einsteinx2/fan_hdd_caddy/(commit log)

2026-06-09 First pass, still needs more refinement
    [fan_hdd_caddy.scad]
2026-06-09 Added ventilation and more structure
    [fan_hdd_caddy.scad]
2026-06-09 First pass at making screws optional
    [fan_hdd_caddy.scad]
2026-06-09 Improve hard drive alignment bumps
    [fan_hdd_caddy.scad]
2026-06-13 Split base and collar to allow printing flat on bed without supports
    [fan_hdd_caddy.scad]
2026-06-13 Add locking tabs to secure the collar
    [fan_hdd_caddy.scad]
2026-06-13 Fixed bumps overlapping base screw holes
    [fan_hdd_caddy.scad]
2026-06-13 Split top stips into separate pieces to remove final need for supports
    [fan_hdd_caddy.scad]
2026-06-13 Add some vertical play for the drives
    [fan_hdd_caddy.scad]
2026-06-13 Remove need for supports when printing the collar
    [fan_hdd_caddy.scad]
2026-06-13 Add export script for 3mf and stl files
2026-06-13 Export the bands upside down to lay flat on bed
    [fan_hdd_caddy.scad]
2026-06-14 Optimize print time and filament usage in main body and square off corners to support any corner radius
    [fan_hdd_caddy.scad]
2026-09-05 Rework the caddy as one rigid piece for a case-top mount
    The caddy now sits on a PC case top, over a 140mm fan under it. The
    corner screws pass through the case into the fan, so the collar that
    wrapped the fan, its rest tabs, and its lock detents have no purpose.
    Remove them.
    The old structure was too flimsy. Add a back wall at the +X end and
    fuse the two top strips into the wall tops, so the caddy is one box.
    The drives slide in from the -X connector end and back up to the wall,
    which sets their X datum. Print with slicer supports under the strips.
    Remove the drive retainer bumps. The user screws the drives down from
    the top, so the drives sit loose in 33mm slots and the free space is
    the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
    [fan_hdd_caddy.scad]
2026-09-05 Relieve the top strips above the corner fan screws for driver access
    The one-piece rework made the top strips integral and added the back wall.
    Both strips overhang the corner fan screws in plan view: the +X strip edge
    sits 1.15mm from the screw axis, and the back wall stands 5.75mm behind it.
    A 9mm screw head and a driver shaft could not pass down to the +X screws.
    Cut a round relief (fan_screw_access_d = head + 2mm) through each strip
    above each corner screw. The cut touches the strips only. The walls, the
    end seats on the walls, and the drive screw pads stay in place. An assert
    checks that the relief clears the last drive's screw countersink on each
    strip (1.75mm solid on the -X strip, 1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
    [fan_hdd_caddy.scad]
2026-09-05 Flip the drive PCB side to -Y so the strip screw holes follow
    The drives now sit with their connector (PCB) face toward -Y. The side
    holes sit 6.35mm in from that face, so the strip screw holes move to
    the other side of each drive centerline. Expose the choice as
    drive_pcb_side so it can be flipped back.
    Claude-Session: https://claude.ai/code/session_019H5MdE25dkcYbzR7WwoAMU
    [fan_hdd_caddy.scad]
2026-09-05 Make the top strips solid with a screw hole for each drive orientation
    Drop the ladder vent cutouts and the drive_pcb_side switch. Each strip
    now carries two countersunk holes per drive, one on each side of the
    drive centerline, so a drive fits with its PCB face toward -Y or +Y.
    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
    [fan_hdd_caddy.scad]
2026-09-05 Shrink the wall hexes to 24mm and match the base hexes to them
    Wall vent holes go from 30mm to 24mm across the flats. The base holes
    grow from 18mm to the same 24mm and now derive from wall_hex_size, so
    the two patterns stay equal. Strut widths are unchanged.
    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
    [fan_hdd_caddy.scad]
2026-09-06 Keep wall hex rows whole so no vent opening has a flat top to bridge
    The wall vent field clipped its outer rows at the top and bottom edge,
    which left a flat span up to a full hex wide at the top of every wall
    opening. That is a bridge to print, and a weak one in PETG.
    In pointy mode, honeycomb_panel_2d now emits only rows that fit wholly
    inside the panel height, so every opening keeps its peaked roof. Hexes
    whose center falls outside the panel width are dropped too, so no thin
    sliver is left at the side edges.
    Raise wall_hex_size from 24 to 27, the largest size that still fits
    three whole rows in the wall height. The base follows it.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
    [fan_hdd_caddy.scad]
2026-09-06 Align the wall vent side edges across all hex rows
    The middle row's half hexes ran to the field edge while the offset rows
    ended at their outermost whole hex's flat side, 1.5mm short. Clip the
    pointy-mode field flush with that flat side so every row ends at the
    same X.
    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
    [fan_hdd_caddy.scad]
